bbassac/midi-merge/docs/guide.html

# MIDI Merge

Un boîtier entre votre clavier et votre synthé : il recopie tout ce que vous jouez et y ajoute potentiomètres, boutons, encodeur et joystick, sur le même canal MIDI.

Arduino UnoShield MIDICode v3Non testé sur matériel

## Matériel

Élément | Qté | Rôle
Arduino Uno | 1 | Cerveau du montage
Shield MIDI (IN / OUT / THRU) | 1 | Optocoupleur d'entrée, sortie, switch RUN/PROG
Potentiomètres | 4 | Contrôle continu (CC)
Boutons on/off | 8 | Contrôles tout ou rien (CC)
Encodeur numérique avec clic | 1 | Valeur 0–127 et remise à 64
Mini joystick 2 axes avec clic | 1 | Pitch bend, modulation, bouton
Prises DIN 5 broches femelles pour panneau | 2 | IN et OUT déportés sur le boîtier (optionnel)
Boîtier, fils, alimentation | — | USB, ou 7–12 V sur la prise jack

## Le principe

Le clavier arrive sur MIDI IN, tout ressort sur MIDI OUT, et vos contrôles s'ajoutent au flux. Sans clavier branché, le boîtier fonctionne seul comme contrôleur.

## Câblage

Les 20 broches de l'Uno sont toutes utilisées. Une couleur par composant, partout dans ce guide.

Shield MIDIEncodeurBoutonsJoystickPotentiomètres

Arduino UnoBroches numériques

Broches analogiques

### Potentiomètres

5 V sur une patte, GND sur l'autre, curseur central vers A0 à A3.

### Joystick

VRx → A4, VRy → A5, SW → D13, plus 5 V et GND.

### Encodeur

CLK → D2, DT → D3, SW → D4, GND. Rotation inversée : échangez CLK et DT.

### Boutons

Un fil sur D5 à D12, l'autre sur GND. Pas de résistance : pull-up interne.

### Shield MIDI

Utilise D0/D1. Switch sur PROG pour téléverser, sur RUN pour jouer.

### Prise THRU

Copie brute de l'entrée, sans vos contrôles. Non utilisée : le synthé se branche sur OUT.

Le shield s'empile sur l'Uno et repasse les broches vers le haut pour câbler les composants. Certains shields MIDI (modèle SparkFun, par exemple) ont des boutons ou des LED sur D2, D3, D6, D7 ou A0 à A2 : ce n'est pas visible sur votre photo, mais si un composant se comporte mal, vérifiez au multimètre.

## Le joystick

Horizontal : pitch bend progressif. Vers le haut : modulation. Vers le bas : rien.

Le centre est calibré à l'allumage : ne touchez pas au joystick à ce moment. Les ±2 demi-tons supposent un synthé réglé sur la plage de bend standard de ±2. Si « haut » ne donne pas de modulation, passez INVERT_Y à true.

## Ce qui sort en MIDI

Les messages ajoutés prennent le canal de la dernière note reçue, ou le canal 1 si le clavier n'a encore rien joué.

### Potentiomètres A0–A3

CC 20, 21, 22, 23 · valeurs 0 à 127

### Joystick, axe X A4

Pitch bend de −8192 à +8191, 0 au centre

### Joystick, axe Y A5

CC 1 (modulation) · 0 au centre, 127 en haut

### Joystick, clic D13

CC 110 · 127 à l'appui, 0 au relâchement

### Encodeur D2 · D3

CC 30 · pas de 2 par cran, de 0 à 127

### Encodeur, clic D4

Remet la valeur de l'encodeur à 64 et envoie CC 30

### 8 boutons D5–D12

CC 102 à 109 · 127 à l'appui, 0 au relâchement (ou bascule avec BUTTONS_TOGGLE)

## Comment le code travaille

La recopie du clavier est confiée à la bibliothèque MIDI. Vos messages partent dans la même boucle, donc mélangés au flux.

MIDI.begin(MIDI_CHANNEL_OMNI);      // écoute tous les canaux
MIDI.turnThruOn(midi::Thru::Full);  // recopie tout vers la sortie

### Réglages anti-perte de l'instance

- Use1ByteParsing = false : lit tout le tampon à chaque read()
- HandleNullVelocityNoteOnAsNoteOff = false : ne modifie pas les Note On de vélocité 0
- UseRunningStatus = true : moins d'octets envoyés
- SysExMaxSize = 256 : un sysex plus long est tronqué (chaque octet consomme de la RAM)

La bibliothèque n'a pas de réglage qui désactive purement la vérification des données : ce sont les options les plus proches.

### Boucle principale

loop():
  MIDI.read()                  // clavier → sortie
  une lecture analogique       // A0 à A5, une par tour
  MIDI.read()
  encodeur, clic joystick, 8 boutons

Une seule lecture analogique (environ 0,1 ms) par tour : le tampon de réception de l'Uno (64 octets, soit ~20 ms de MIDI) ne déborde pas. La variable step revient à 0 par un modulo, donc aucun dépassement possible.

### Potentiomètres

Lecture 10 bits, filtre de bruit (variation d'au moins 4 sur 1023), conversion en 7 bits, envoi seulement si la valeur change.

### Joystick

Centre calibré au démarrage, zone morte de 25, butée 40 avant la fin de course. Bend envoyé si la variation dépasse 48, ou au retour exact au centre ou aux butées.

### Encodeur

Table d'états : 4 transitions = 1 cran. Pas de 2, valeur bornée à 0–127, clic = retour à 64.

### Boutons

Anti-rebond de 20 ms. Momentané par défaut (127 / 0), ou bascule avec BUTTONS_TOGGLE.

### Canal

Mis à jour à chaque Note On ou Note Off reçu. Canal 1 tant que le clavier n'a rien joué.

### Sans clavier

Le boîtier fonctionne en contrôleur autonome : MIDI.read() ne bloque pas, rien à recopier.

## Réglages modifiables

Tout en haut du fichier .ino.

Constante | Défaut | Effet
POT_CC[4] | 20 à 23 | CC des potentiomètres
BTN_CC[8] | 102 à 109 | CC des boutons
JOY_Y_CC | 1 | CC de l'axe Y (1 = modulation)
JOY_SW_CC | 110 | CC du clic joystick
ENC_CC / ENC_STEP | 30 / 2 | CC et incrément de l'encodeur
BUTTONS_TOGGLE | false | true : chaque appui bascule 0/127
JOY_DEADZONE | 25 | Zone morte du joystick (sur 1023)
JOY_MARGIN | 40 | Marge avant la butée
INVERT_Y | false | true si « haut » ne donne pas de modulation
SysExMaxSize | 256 | Taille maximale d'un sysex recopié

## Mise en route

1. Installez la bibliothèque MIDI Library (Francois Best) dans l'IDE Arduino.
2. Mettez le switch du shield sur PROG et téléversez midi_merge_v3.ino.
3. Remettez le switch sur RUN.
4. Clavier sur MIDI IN, synthé sur MIDI OUT. Alimentation par USB ou 7–12 V.
5. Ne touchez pas au joystick pendant la mise sous tension.

## Si ça ne marche pas

Rien ne sort du tout

Vérifiez la position du switch du shield : RUN pour jouer, PROG pour téléverser. Contrôlez aussi que le synthé est bien sur MIDI OUT et non sur THRU.

Les notes du clavier ne ressortent pas

Testez le matériel seul avec ce mini-sketch. Si les notes ressortent, le câblage est bon et le défaut vient du code.

void setup() { Serial.begin(31250); }
void loop()  { if (Serial.available()) Serial.write(Serial.read()); }

Des CC aléatoires apparaissent

Une entrée analogique n'est pas câblée et capte du bruit. Branchez le potentiomètre manquant, ou reliez l'entrée à GND.

Voir les messages en clair sans le shield

Branchez l'Uno en USB, lancez Hairless MIDI↔Serial Bridge à 31250 bauds avec un port virtuel (loopMIDI), puis ouvrez MIDI-OX ou MIDIberry.

Tester le contrôleur autonome

Sans rien sur MIDI IN, téléversez la v3 et branchez OUT sur un synthé ou une interface : bougez les composants, les messages sortent sur le canal 1.

Simuler avec Wokwi

Wokwi (wokwi.com) simule un Uno avec potentiomètres, boutons, encodeur et joystick. Il n'affiche pas le MIDI en clair et ne simule pas de clavier en entrée : il vérifie que les composants réagissent, mais ne remplace pas Hairless.

Test complet

Clavier sur IN, synthé sur OUT : jouez des notes en tournant un potentiomètre ou en bougeant le joystick. Les notes doivent sonner sans trou, et les contrôles agir sur le même canal.

### Autres symptômes

Symptôme | Cause probable | Action
Téléversement impossible | Switch sur RUN, ou clavier branché | Passer en PROG, débrancher le MIDI IN
Les contrôles sortent, mais pas le clavier | Entrée seule en défaut : broches 4 et 5 du DIN IN inversées, câble | Inverser les broches 4 et 5 de l'entrée
Notes reçues mais pas les CC | CC non assignés dans le synthé | « MIDI learn » ou moniteur MIDI
Pitch bend décalé au repos | Joystick touché au démarrage | Redémarrer sans y toucher
Joystick Y inversé | Montage mécanique | INVERT_Y = true
Encodeur à l'envers | CLK et DT inversés | Échanger les deux fils
Bend sans effet audible | Plage de bend du synthé à 0 | Régler la plage à ±2 dans le synthé
Un bouton envoie plusieurs messages | Rebonds importants | Augmenter l'anti-rebond (20 ms)
Sysex tronqué ou perdu | Plus long que SysExMaxSize | Augmenter la valeur (consomme de la RAM)
Notes perdues pendant des gestes rapides | Charge trop forte sur la boucle | Retirer les composants inutilisés, ou passer à une recopie par octets

## Boîtier et prises MIDI déportées

### A. Dessouder

Dessoudez les prises IN et OUT du shield et reliez des prises DIN panneau par des fils courts (10 à 30 cm), de préférence torsadés. Photographiez et repérez chaque trou avant.

### B. Sans soudure

Branchez sur les prises du shield des rallonges DIN 5 broches avec prise femelle à fixer sur panneau (« MIDI panel mount extension cable »). Réversible, plus encombrant.

Prise | Broches | Rôle
OUT | 5, 4, 2 | 5 = signal, 4 = +5 V via 220 Ω, 2 = masse
IN | 4 et 5 | Boucle de courant vers l'optocoupleur

- Les broches 1 et 3 ne servent pas. Ne reliez pas la broche 2 de l'entrée IN.
- Rien n'arrive à l'Arduino : inversez les broches 4 et 5 de l'entrée.
- Fils courts, éloignés des potentiomètres et du joystick.
- Boîtier métallique : isolez les prises (collerette plastique ou rondelle) pour éviter une boucle de masse.
- Rallonges du commerce : 5 conducteurs, câblage 1:1, 180° (ni 240°, ni 3 broches). Il en faut 2 ; le THRU est inutile ici.

## Limites et évolutions

### Limites connues

- Code non testé sur matériel.
- Les 20 broches sont prises : pas de LED, d'afficheur ni de logs sans en libérer une.
- Le traitement des composants s'ajoute au trajet du MIDI (latence faible).
- Un sysex plus long que SysExMaxSize peut être tronqué.

### Évolutions possibles

- Recopie octet par octet avec tampon, si la bibliothèque pose problème.
- Envoi d'un RPN au démarrage pour forcer la plage de bend à ±2.
- Canal fixe réglable, ou choisi avec l'encodeur.
- Carte Mega pour ajouter des contrôles ou des LED.

Le code source complet (v3) se trouve dans midi_merge_v3.ino et en annexe de documentation_midi_merge.md.
