bbassac/midi-merge/(commit log)

2026-11-04 fix pot threshold + monitoring
    [midi-merge.ino, moniteur_midi.py]
2026-11-08 Fix interruptions et lecture analogique
    [midi-merge.ino]
